edocrippaofficial/Object-Follower-Camera/(commit log)

2019-11-28 Modified PID in order to output 0 if objects are not found, other minor modifications
2019-11-29 PID tuning
2020-06-09 Video di esempio
